mmeisel/timer/cad/timer-front-panel.dxf

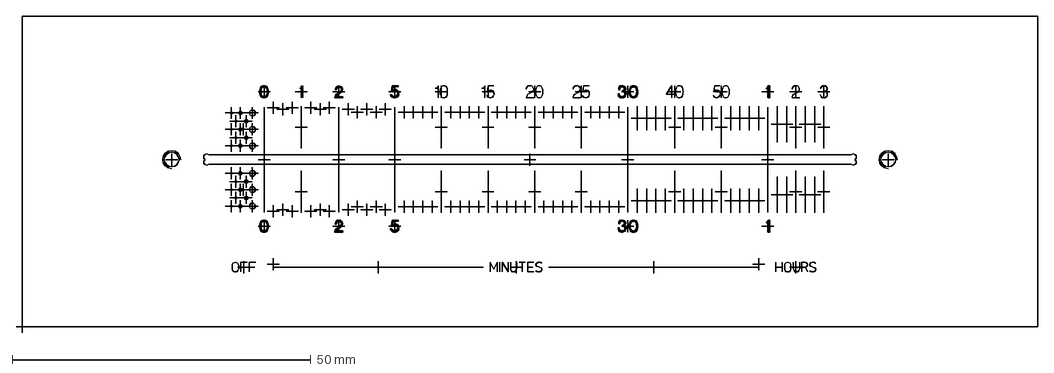
[picture p1: CAD file, 2017-10-18]
cad/timer-front-panel.dxf
171.0 x 53.0 mm
