mmeisel/timer/(list of files, cad)

Other CAD files:
cad/threads.scad
