mmeisel/timer/cad/timer.kicad_pcb

## KiCad design cad/timer.kicad_pcb (2023-01-24)

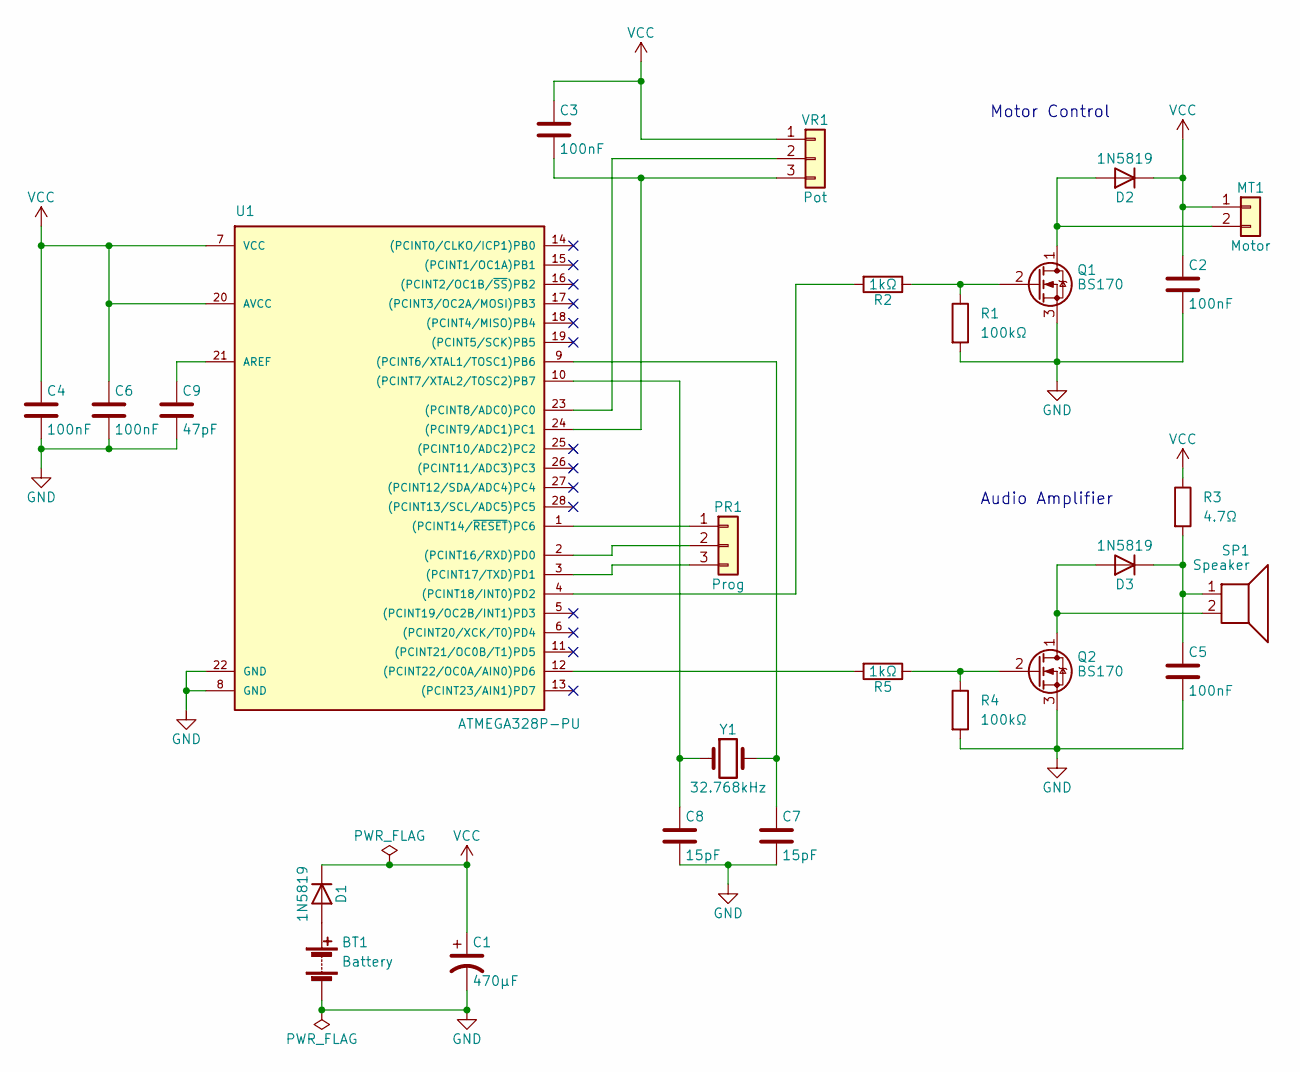
[picture p2: schematic timer.kicad_sch]

Parts:
BT1: Battery; PinHeader_1x02_P2.54mm_Vertical
C1: 470µF; CP_Radial_D10.0mm_P5.00mm
C2, C3, C4, C5, C6: 100nF; C_Disc_D5.0mm_W2.5mm_P5.00mm
C7, C8: 15pF; C_Disc_D5.0mm_W2.5mm_P2.50mm
C9: 47pF; C_Disc_D5.0mm_W2.5mm_P2.50mm
D1, D2, D3: 1N5819; D_DO-41_SOD81_P2.54mm_Vertical_KathodeUp
MT1: Motor; PinHeader_1x02_P2.54mm_Vertical
PR1: Prog; PinHeader_1x03_P2.54mm_Vertical
Q1, Q2: BS170; TO-92_Inline_Wide
R1, R4: 100kΩ; R_Axial_DIN0207_L6.3mm_D2.5mm_P2.54mm_Vertical
R2, R5: 1kΩ; R_Axial_DIN0207_L6.3mm_D2.5mm_P2.54mm_Vertical
R3: 4.7Ω; R_Axial_DIN0207_L6.3mm_D2.5mm_P2.54mm_Vertical
SP1: Speaker; PinHeader_1x02_P2.54mm_Vertical
U1: ATMEGA328P-PU; DIP-28_W7.62mm_Socket
VR1: Pot; PinHeader_1x03_P2.54mm_Vertical
Y1: 32.768kHz; Crystal_C38-LF_D3.0mm_L8.0mm_Vertical

Connections:
GND: BT1.2 (-), C1.2, C2.2, C4.2, C5.2, C6.2, C7.2, C8.2, C9.2, Q1.3 (S), Q2.3 (S), R1.2, R4.2, U1.8 (GND), U1.22 (GND)
unnamed: BT1.1 (+), D1.2 (A)
unnamed: C3.2, U1.24 ((PCINT9/ADC1)PC1), VR1.3
unnamed: C5.1, D3.1 (K), R3.2, SP1.1
unnamed: C7.1, U1.9 ((PCINT6/XTAL1/TOSC1)PB6), Y1.2
unnamed: C8.1, U1.10 ((PCINT7/XTAL2/TOSC2)PB7), Y1.1
unnamed: C9.1, U1.21 (AREF)
unnamed: D2.2 (A), MT1.2, Q1.1 (D)
unnamed: D3.2 (A), Q2.1 (D), SP1.2
unnamed: PR1.1, U1.1 ((PCINT14/~RESET)PC6)
unnamed: PR1.2, U1.2 ((PCINT16/RXD)PD0)
unnamed: PR1.3, U1.3 ((PCINT17/TXD)PD1)
unnamed: Q1.2 (G), R1.1, R2.1
unnamed: Q2.2 (G), R4.1, R5.1
unnamed: R2.2, U1.4 ((PCINT18/INT0)PD2)
unnamed: R5.2, U1.12 ((PCINT22/OC0A/AIN0)PD6)
unnamed: U1.23 ((PCINT8/ADC0)PC0), VR1.2
VCC: C1.1, C2.1, C3.1, C4.1, C6.1, D1.1 (K), D2.1 (K), MT1.1, R3.1, U1.7 (VCC), U1.20 (AVCC), VR1.1

Notes on the sheet:
Audio Amplifier
Motor Control

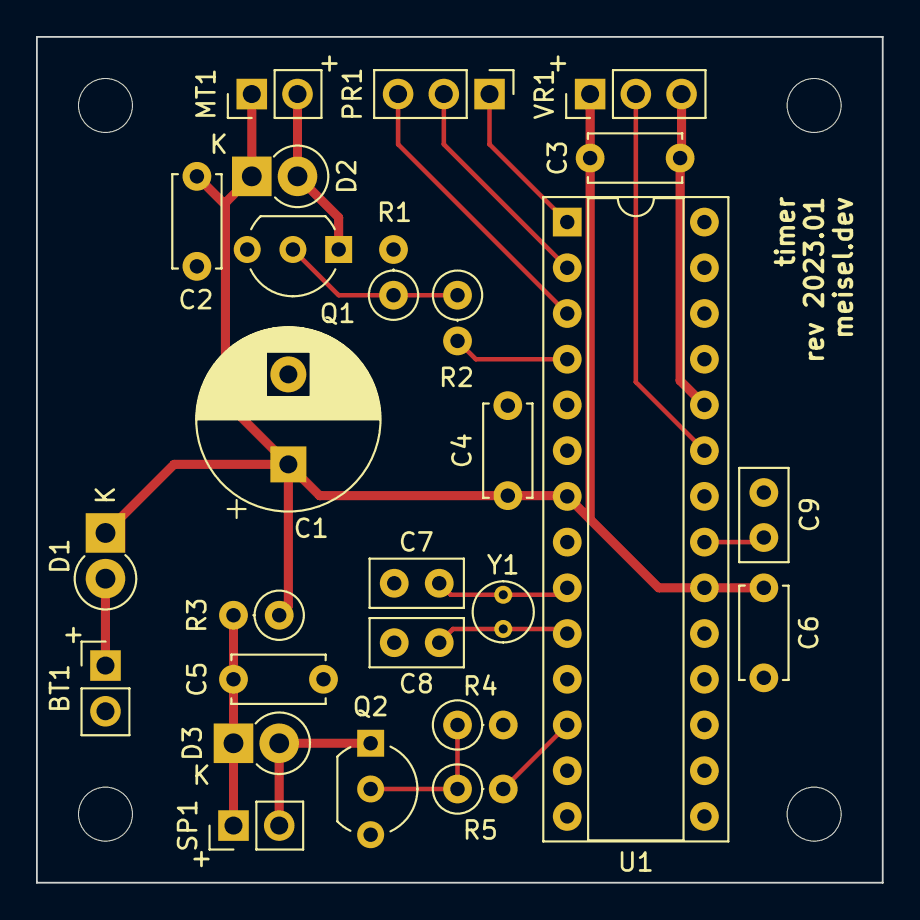
[picture p3: board timer.kicad_pcb from above]

Board: 2 copper layers, 47.0 x 47.0 mm, 30 parts (0 on the bottom side), 18 nets.

Other parts of the board:
H1, H2, H3, H4: MountingHole_3mm
