mmeisel/timer/audio.h

#ifndef __TIMER_AUDIO_H__
#define __TIMER_AUDIO_H__

#include <avr/pgmspace.h>

namespace audio {

const uint8_t DATA[] PROGMEM = {
    0x00, 0x03, 0x06, 0x09, 0x12, 0x15, 0x18, 0x21, 0x25, 0x29, 0x33, 0x37, 0x42, 0x47, 0x52, 0x57,
    0x62, 0xdb, 0x58, 0x7b, 0x4c, 0xba, 0x8e, 0x16, 0xaf, 0x4d, 0xf3, 0x1e, 0x90, 0x90, 0x88, 0xc9,
    0x00, 0xc4, 0x61, 0x99, 0x8c, 0x27, 0xe0, 0x55, 0xa8, 0x60, 0x61, 0xe1, 0x37, 0xb1, 0x43, 0x91,
    0xb8, 0x2b, 0xaf, 0x3c, 0xc0, 0x80, 0x36, 0xb9, 0x4c, 0xda, 0x3f, 0x68, 0xa5, 0x61, 0xcb, 0x14,
    0xa0, 0x90, 0x79, 0x9e, 0x1a, 0xd5, 0x70, 0x8a, 0x71, 0x3f, 0xd6, 0x44, 0x9a, 0x4d, 0x88, 0xcc,
    0x2f, 0xab, 0x48, 0xb9, 0x9c, 0x2e, 0xb0, 0x4c, 0xd8, 0x54, 0x52, 0xb9, 0x5e, 0xd1, 0x25, 0x92,
    0xa2, 0x6d, 0xad, 0x13, 0xc5, 0x84, 0x7c, 0x88, 0x36, 0xed, 0x5b, 0x8b, 0x63, 0x69, 0xe0, 0x2e,
    0x9b, 0x51, 0xa7, 0xb1, 0x2d, 0xb4, 0x51, 0xcc, 0x6f, 0x3f, 0xb2, 0x58, 0xcb, 0x34, 0x7b, 0xb1,
    0x6b, 0xb9, 0x20, 0xb8, 0x8b, 0x70, 0x89, 0x2b, 0xdd, 0x64, 0x83, 0x70, 0x61, 0xe7, 0x43, 0x8f,
    0x5e, 0x90, 0xc2, 0x20, 0xa7, 0x5a, 0xba, 0x8e, 0x38, 0xc0, 0x57, 0xcf, 0x44, 0x5d, 0xba, 0x62,
    0xb7, 0x22, 0xad, 0xa4, 0x6d, 0xa4, 0x2d, 0xd7, 0x77, 0x72, 0x77, 0x47, 0xe8, 0x48, 0x89, 0x6c,
    0x87, 0xd7, 0x29, 0x9d, 0x5d, 0xac, 0x92, 0x21, 0xb6, 0x59, 0xc2, 0x5e, 0x56, 0xc2, 0x5e, 0xc0,
    0x2a, 0x84, 0xa8, 0x5c, 0xa1, 0x21, 0xc7, 0x8a, 0x6a, 0x8e, 0x3d, 0xef, 0x53, 0x74, 0x72, 0x66,
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
    0x8e, 0x69, 0x89, 0x50, 0xd6, 0x5a, 0x76, 0x77, 0x70, 0xcd, 0x39, 0x91, 0x71, 0xa0, 0xa4, 0x27,
    0xac, 0x6c, 0xae, 0x6b, 0x4e, 0xbc, 0x64, 0xae, 0x41, 0x78, 0xbb, 0x68, 0x99, 0x38, 0xb0, 0x95,
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
};

const int DATA_SIZE = sizeof(DATA) / sizeof(uint8_t);

}

#endif
