mmeisel/timer/(commit log)

2017-07-17 First attempt
    - Using PID to set slider position (untested)
    - Working feedback mechanism with linear scale
2017-07-18 Mostly failed attempt to work with H-Bridge
    [timer.ino]
2017-07-18 Not working version with PID
    [timer.ino]
2017-07-19 Fix detentes and improve change detection
    [timer.ino]
2017-07-20 Always snap to previous position, some cleanup
    [timer.ino]
2017-08-06 Add interrupt for external slide detection circuit
    This doesn't actually do much yet since the microprocessor only sleeps
    for at most 1 ms until the next interrupt for millis(), and it's using
    the highest power sleep mode (idle).
    This will actually start to be useful when using a crystal for the clock
    instead of the Arduino library's (interrupt-based) millis().
    [timer.ino]
2017-08-06 Simpler interrupt handling
2017-08-06 Initial attempt at interrupt-based timing
2017-08-06 Use correct sleep mode for interrupt-based timing
    [timer.ino]
2017-08-07 Mostly working low power version!
2017-08-08 Some important tweaks for correct operation
    [timer.ino]
2017-08-08 Try getting rid of DIR_STOP, doesn't seem to do much
    [stopwatch.cpp, timer.ino]
2017-08-14 Better Timer2 register handling
2017-08-14 Improvements and bug fixes
    - Generate stops on startup instead of on demand
    - Better debug messages
    - Fix tick bug
    - Don't allow the motor to be interrupted
    [stop.cpp, stop.h, stopwatch.cpp, timer.ino]
2017-08-14 Fix timing issues by waiting for crystal to stabilize
    [timer.ino]
2017-08-24 We're using millis() now
2017-08-24 Some cleanup, tweaks, and notes
    Including:
    - Remove redundant call to updateBell()
    - Better name for power on/off interrupt pin
2017-08-28 Wait for crystal to stabilize by comparing with millis()
    [stop.cpp, stopwatch.cpp, stopwatch.h, timer.ino]
2017-09-01 PCM: Use Timer0 instead of Timer2
2017-09-04 PCM: Changes for project compatibility
    - Reset Timer0 to previous state when audio completes
    - Add isPlaying() function
    [PCM.c, PCM.h]
2017-09-14 Initialize speaker pin to low
    Otherwise, it wastes power.
2017-09-14 Fixes for sound generation
    - Don't do anything else while a sound is playing
    - Wait until the motor is done moving the slider into position before
    trying to generate audio
    [timer.ino]
2017-09-15 Notes on Class B amplifier circuit
2017-09-15 PCM: Just disable Timer0 instead of restoring it
    Partially reverts 548f2e9945915deeff77d4df83d5430c6061481a
    [PCM.c]
2017-09-15 Remove use of millis() in debug output
    This is already pretty useless and will soon be disabled.
2017-09-15 PCM: Safer handling of registers
    The PCM code is taking control of these timers, so it should just set
    the entire register, too.
2017-09-15 Fix stopwatch overflow bug
    The subtraction needs to be cast to a signed integer with the same
    number of bits, or the trick doesn't work.
    [clock.cpp]
2017-09-15 Use Timer0 directly for stabilization
    This is more accurate than using millis().
2017-09-15 Expose current clock time
2017-09-15 Improve adc reliability
    - Don't try to start two conversions at once
    - Use idle instead of ADC noise reduction low-power mode to avoid
    interfering with Timer2
    [adc.cpp]
2017-09-15 Prevent double-firing of Timer2 overflow interrupt
    This can happen if sleep is entered too quickly after the interrupt
    occurs. As the datasheet recommends, write a value to one of the Timer2
    registers and wait for the asynchronous register to clear to ensure a
    cycle has passed and it is safe to enter a low power mode.
    [clock.cpp, clock.h, timer.ino]
2017-09-15 Switch motor driver on/off with transistor
2017-09-18 Add schematic and unfinished PCB
    [timer.kicad_pcb, timer.sch]
2017-09-20 CAD files for first PCB attempt
    [timer-B.Cu.gbl, timer-Edge.Cuts.gm1, timer-F.Cu.gtl, timer-F.Mask.gts, timer-F.Paste.gtp, timer-F.SilkS.gto, timer-NPTH.drl, timer.drl]
2017-09-20 Through-hole parts are on front AND back!
    [timer-B.Cu.gbl, timer-B.Mask.gbs, timer-B.Paste.gbp, timer-B.SilkS.gbo, timer-F.Cu.gtl, timer-F.Paste.gtp, timer-F.SilkS.gto, timer-NPTH.drl]
2017-09-20 Larger off stop
    No need for zero to be bigger than the other stops, better to have a
    little extra space for the off position. The soft power switch will need
    to have its resistor adjusted accordingly.
2017-09-20 CAD changes for off stop size change
    The soft power switch needs a 68k instead of a 47k resistor now.
    [timer.kicad_pcb, timer.sch]
2017-10-17 Fix outdated motor-related comment, add note
    [timer.ino]
2017-10-18 Exported front panel in DXF format
    [timer-front-panel.dxf]
2017-11-08 PCB: Q2 and Q3 labels were switched!
    [timer.kicad_pcb]
2017-11-30 Basic version of 3D-modeled front panel
    Using OpenSCAD
    [threads.scad, timer-front-panel.scad]
2017-11-30 Clean up front panel slightly
    [timer-front-panel.scad]
2017-11-30 SCAD code cleanup (fewer braces)
    [timer-front-panel.scad]
2017-11-30 Front panel: added detentes
    [timer-front-panel.scad]
2017-11-30 Front panel: fancier off markings
    The same halftone dots as in the Front Panel Designer version
    [timer-front-panel.scad]
2017-11-30 Front panel: Alternate OFF markings
    With the "OFF" label
    [timer-front-panel.scad]
2017-11-30 Front panel: Fix misconfigured polyhedron
    [timer-front-panel.scad]
2017-11-30 Front panel: Make panel depth adjustable
    [timer-front-panel.scad]
2017-11-30 Front panel: Deeper engravings
    [timer-front-panel.scad]
2017-12-02 New 2D version of front panel
    This one is for laser cutting
    [timer-front-panel-2d.scad, timer-front-panel-3d.scad]
2017-12-05 2D front panel: More overlap with knob
    [timer-front-panel-2d.scad]
2017-12-05 SIGNIFICANT_POSITION_CHANGE is no longer needed
    Using the middle of the stop as the target makes a false detection of
    movement much less likely, so this shouldn't be necessary.
    [timer.ino]
2017-12-06 Enclosure 3D model (WIP)
    Currently, this only has prototypes of the rear and bottom panels.
    [enclosure.scad]
2017-12-07 Front panel: Spread OFF marks to match longer lines
    [timer-front-panel-2d.scad]
2017-12-10 Further progress on enclosure for 3D printing
    However, I'm giving up on this approach in favor of laser cutting.
    [enclosure.scad]
2017-12-12 Start of 2D enclosure for laser cutting
    Still very much WIP. First version of top and back panels.
    [enclosure-2d.scad]
2017-12-14 More progress on new enclosure
    Still to do:
    - Fix kerf issues
    - Add front panel
    - Add interior panel
    - Add something to mount the battery
    [enclosure-2d.scad]
2017-12-14 Fixed some kerf issues with 2D enclosure
    [enclosure-2d.scad]
2017-12-14 Added all panels, still some TODOs
    [enclosure-2d.scad]
2017-12-15 Enclosure: Make front panel optional
    [enclosure-2d.scad]
2017-12-15 Fit both batteries and PCB on bottom
    [enclosure-2d.scad]
2017-12-17 Add correct measurements for slider hole
    [enclosure-2d.scad]
2017-12-17 Add screw holes to front panel
    [timer-front-panel-2d.scad]
2017-12-17 Line all parts up
    Two sets will fit on one Ponoko P2 panel this way!
    [enclosure-2d.scad]
2017-12-17 SVG files for Ponoko laser cut order
    Sent to Ponoko for first run
2017-12-21 Add missing $fn for some screw holes
    [enclosure-2d.scad]
2017-12-22 Tweak hinge hole position so back panel is flush
    [enclosure-2d.scad]
2017-12-27 Front panel: Enlarge numbers a bit
    [timer-front-panel-2d.scad]
2017-12-27 Front panel: Remove corner screw holes
    No need for the holes, I can just glue it
    [timer-front-panel-2d.scad]
2017-12-27 Front panel: Fix inaccuracy due to slider properties
    According to the datasheet, the slider potentiometer output voltage
    doesn't change for the first or last 2 (+- 1) mm of travel. So spead the
    markings across 96mm instead of 100mm.
    [timer-front-panel-2d.scad]
2017-12-27 Front panel: More visible off markings
    [timer-front-panel-2d.scad]
2017-12-27 Front panel: Some tweaks for next run
    - I'm giving up on the tactile feedback for now, so reduce the overlap
    between the knob and the lines
    - Make the lines thinner (they'll just be engraved now)
    - Shrink the width of the slider opening so it stops when it hits the
    plastic instead of at its ultimate limit
    [timer-front-panel-2d.scad]
2017-12-30 Reposition the slider to the center of the stop
    After someone sets the stop manually, move the slider to the center of
    the stop. This serves two purposes:
    - It prevents the timer from getting stuck between two stops when
    positioned at a stop boundary
    - It gives the user some feedback as to which stop was selected
    [timer.ino]
2017-12-30 More reliable motor controller switch
    The previous resistor/transistor combo wasn't reliable
    [timer.sch]
2018-01-07 Remove separate power switch for motor controller
    This was causing all sorts of problems, just go back to the original,
    simpler setup where the enable pin and logic supply voltage pin are
    connected (thus only powering the chip when enabling the motor).
    [timer.sch]
2018-01-07 Remove unused motor function
2018-01-07 Updated schematic and PCB design
    - Increased hole size to 3mm
    - Removed motor controller on/off switch (Q1 and R3)
    - Swap transistor footprint for one that's easier to solder
    - Reroute with FreeRoutingNew
    [timer.kicad_pcb, timer.sch]
2018-01-10 Refactor for reverse-only motor control
    The L293D has too big a voltage drop to run the already undervolted
    motor on the slider. It both drops Vcc and raises ground due to the
    transistors in the H-bridge.
    [motor.cpp, motor.h, stop.cpp, timer.ino]
2018-01-11 Remove extraneous setting of ouptut mode on PCM pin
2018-01-12 Schematic for updated design
    - Now using MOSFETs for both motor and audio switching
    - Added a bunch of bypass/decoupling capacitors
    [timer.sch]
2018-01-12 New PCB design to match new schematic
    - Isolated power networks with decoupling capacitors
    - Top layer is ground, bottom layer is VCC (this seems to be the
    convention)
    - Hopefully better placement of ports for external devices
    [timer-B.Cu.gbl, timer-B.Mask.gbs, timer-B.Paste.gbp, timer-B.SilkS.gbo, timer-Edge.Cuts.gm1, timer-F.Cu.gtl, timer-F.Mask.gts, timer-F.Paste.gtp]
2018-01-16 Some enclosure assembly notes
2018-01-16 Enclosure: Add some wiggle room for door
    [enclosure-2d.scad]
2018-01-20 New ringing behavior
    - The timer will now only ring a set number of times, then turn itself
    off. This way it won't just keep ringing until it drains the battery
    if it's left ringing unattended.
    - Allow the delay to be variable between rings by providing an array of
    delay intervals.
    [timer.ino]
2018-02-09 Some notes on battery holders and enclosure
2018-03-28 Widen the door tab to match the size of the magnets
    This will now fit the adhesive magents at their manufactured width.
    [enclosure-2d.scad]
2018-03-28 New battery holder
    [enclosure-2d.scad]
2018-03-28 Rearrange parts to fit better in ponoko template
    [enclosure-2d.scad]
2018-03-28 Fix tilt angle, bottom depth, and clean up code
    [enclosure-2d.scad]
2018-03-28 I only need one of these!
    [enclosure-2d.scad]
2018-03-28 Avoid rounded edges when using offset()
    [enclosure-2d.scad]
2018-03-28 Add some padding to battery rail cutouts
    For some reason the rendering of these was imprecise.
    [enclosure-2d.scad]
2018-03-28 Update enclosure SVG files
    Note that the battery crossbar was manually combined with the slider
    cutout using inkscape.
2018-04-11 Hard limit on how long clock stabilization can take
    This prevents the timer from freezing up completely if the crystal never
    stabilizes. The timekeeping may not be accurate if this happens, but
    that's probably better than it just breaking completely until you take
    the batteries out and put them back in again.
    [clock.cpp]
2018-08-21 Enclosure tweaks
    - Remove battery crossbar
    - Slightly more room for battery holder
    - Move PCB mount a bit closer to the rear door
    [enclosure-2d.scad]
2021-10-12 Prevent warning on newer OpenSCAD
    [enclosure-2d.scad]
2021-10-22 Changes from new kicad version
    [timer.sch]
2022-10-10 Further changes from latest KiCad version
    [timer.kicad_pcb, timer.kicad_sch]
2023-01-05 Don't enter ADC noise reduction mode too quickly
    [adc.cpp]
2023-01-09 Reset bell parameters any time stop zero is hit
    [timer.ino]
2023-01-17 Give feedback when timer is set
    - Feedback is by playing the second half of the bell sound, which
    sounds like a quieter ring of the bell
    - Also improve debug logging and config system
2023-01-20 Take most precise possible ADC measurements
2023-01-21 Change pin to accomodate PCB layout
2023-01-21 Update CAD for redesign
    Also cleanup old files in cad directory
    [timer-B.Cu.gbl, timer-B.Mask.gbs, timer-B.SilkS.gbo, timer-B_Cu.gbl, timer-B_Mask.gbs, timer-B_Paste.gbp, timer-B_Silkscreen.gbo, timer-Edge.Cuts.gm1]
2023-01-21 Label PCB
    [timer-B_Cu.gbl, timer-B_Mask.gbs, timer-B_Paste.gbp, timer-B_Silkscreen.gbo, timer-Edge_Cuts.gm1, timer-F_Cu.gtl, timer-F_Mask.gts, timer-F_Paste.gtp]
2023-01-24 Add markers for positive terminals
    [timer-B_Cu.gbl, timer-B_Mask.gbs, timer-B_Paste.gbp, timer-B_Silkscreen.gbo, timer-Edge_Cuts.gm1, timer-F_Cu.gtl, timer-F_Mask.gts, timer-F_Paste.gtp]
2023-01-24 Prevent false human detection when motor is running
    [timer.ino]
2023-01-24 Missed one positive terminal marker
    [timer-B_Cu.gbl, timer-B_Mask.gbs, timer-B_Paste.gbp, timer-B_Silkscreen.gbo, timer-Edge_Cuts.gm1, timer-F_Cu.gtl, timer-F_Mask.gts, timer-F_Paste.gtp]
